protoplant/layer-adhesion-tester/(threads)

Thread 1 (2024-11-17):

Cannot compile code in IDE

makoman1860, 2024-11-17:
Keep getting the following error:
C:\Users\novak\AppData\Local\Temp\.arduinoIDE-unsaved20241017-6828-12k9i9d.rv2df\sketch_nov17a\sketch_nov17a.ino:3:4: error: stray '\' in program
 }c:\Users\novak\OneDrive\Documents\Arduino\layer-adhesion-tester-main\layer-adhesion-tester\layer-adhesion-tester.ino
    ^
C:\Users\novak\AppData\Local\Temp\.arduinoIDE-unsaved20241017-6828-12k9i9d.rv2df\sketch_nov17a\sketch_nov17a.ino:3:10: error: stray '\' in program
 }c:\Users\novak\OneDrive\Documents\Arduino\layer-adhesion-tester-main\layer-adhesion-tester\layer-adhesion-tester.ino
          ^
C:\Users\novak\AppData\Local\Temp\.arduinoIDE-unsaved20241017-6828-12k9i9d.rv2df\sketch_nov17a\sketch_nov17a.ino:3:16: error: stray '\' in program
 }c:\Users\novak\OneDrive\Documents\Arduino\layer-adhesion-tester-main\layer-adhesion-tester\layer-adhesion-tester.ino
                ^
C:\Users\novak\AppData\Local\Temp\.arduinoIDE-unsaved20241017-6828-12k9i9d.rv2df\sketch_nov17a\sketch_nov17a.ino:3:25: error: stray '\' in program
 }c:\Users\novak\OneDrive\Documents\Arduino\layer-adhesion-tester-main\layer-adhesion-tester\layer-adhesion-tester.ino
                         ^
C:\Users\novak\AppData\Local\Temp\.arduinoIDE-unsaved20241017-6828-12k9i9d.rv2df\sketch_nov17a\sketch_nov17a.ino:3:35: error: stray '\' in program
 }c:\Users\novak\OneDrive\Documents\Arduino\layer-adhesion-tester-main\layer-adhesion-tester\layer-adhesion-tester.ino
                                   ^
C:\Users\novak\AppData\Local\Temp\.arduinoIDE-unsaved20241017-6828-12k9i9d.rv2df\sketch_nov17a\sketch_nov17a.ino:3:43: error: stray '\' in program
 }c:\Users\novak\OneDrive\Documents\Arduino\layer-adhesion-tester-main\layer-adhesion-tester\layer-adhesion-tester.ino
                                           ^
C:\Users\novak\AppData\Local\Temp\.arduinoIDE-unsaved20241017-6828-12k9i9d.rv2df\sketch_nov17a\sketch_nov17a.ino:3:70: error: stray '\' in program
 }c:\Users\novak\OneDrive\Documents\Arduino\layer-adhesion-tester-main\layer-adhesion-tester\layer-adhesion-tester.ino
                                                                      ^
C:\Users\novak\AppData\Local\Temp\.arduinoIDE-unsaved20241017-6828-12k9i9d.rv2df\sketch_nov17a\sketch_nov17a.ino:3:92: error: stray '\' in program
 }c:\Users\novak\OneDrive\Documents\Arduino\layer-adhesion-tester-main\layer-adhesion-tester\layer-adhesion-tester.ino
                                                                                            ^
C:\Users\novak\AppData\Local\Temp\.arduinoIDE-unsaved20241017-6828-12k9i9d.rv2df\sketch_nov17a\sketch_nov17a.ino:3:1: error: expected declaration before '}' token
 }c:\Users\novak\OneDrive\Documents\Arduino\layer-adhesion-tester-main\layer-adhesion-tester\layer-adhesion-tester.ino
 ^

exit status 1

Compilation error: stray '\' in program

rekursiv, 2024-11-26:
Looks like your directory structure in your Arduino project is not set up properly.  If you clone the entire repo into your "Sketchbook" directory, within a subdirectory named "layer-adhesion-tester," then it should compile, as long as your IDE is set up correctly.  Note that you need the subdirectory and files within the "src" directory in the repo, as the project makes use of the "hx711-pico-c" library.

Closed 2025-09-17.

Thread 2 (2024-11-17):

ERPROM.h not found

makoman1860, 2024-11-17:
C:\Users\novak\OneDrive\Documents\GitHub\layer-adhesion-tester\layer-adhesion-tester.ino:37:10: fatal error: EEPROM.h: No such file or directory
 #include <EEPROM.h>
          ^~~~~~~~~~
compilation terminated.
exit status 1

Compilation error: EEPROM.h: No such file or directory

rekursiv, 2024-11-26:
Did you follow the [instructions here](https://arduino-pico.readthedocs.io/en/stable/install.html) for installing Arduino-Pico?
If so, could you please verify its installation in the "Boards Manager?"
(Example screen shot attached)
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
