protoplant/layer-adhesion-tester/serialplot.ini

[MainWindow]
size=@Size(1658 1351)
pos=@Point(55 28)
activePanel=Port
hidePanels=false
maximized=false
state=@ByteArray(\0\0\0\xff\0\0\0\0\xfd\0\0\0\0\0\0\x6z\0\0\x4\xd7\0\0\0\x4\0\0\0\x4\0\0\0\b\0\0\0\b\xfc\0\0\0\x1\0\0\0\x2\0\0\0\x3\0\0\0\f\0t\0\x62\0P\0l\0o\0t\x1\0\0\0\0\xff\xff\xff\xff\0\0\0\0\0\0\0\0\0\0\0\x1a\0t\0\x62\0P\0o\0r\0t\0\x43\0o\0n\0t\0r\0o\0l\x1\0\0\0q\xff\xff\xff\xff\0\0\0\0\0\0\0\0\0\0\0\x10\0t\0\x62\0R\0\x65\0\x63\0o\0r\0\x64\x1\0\0\x1\xba\xff\xff\xff\xff\0\0\0\0\0\0\0\0)

[Port]
selectedPort=
baudRate=9600
parity=none
dataBits=8
stopBits=1
flowControl=none

[DataFormat]
format=ascii

[DataFormat_Binary]
numOfChannels=2
numberFormat=uint8
endianness=little

[DataFormat_ASCII]
numOfChannels=2
delimiter=","
customDelimiter=}
filterMode=disabled
filterPrefix=" "

[DataFormat_CustomFrame]
numOfChannels=1
numberFormat=uint8
endianness=little
frameStart=AA BB
fixedSize=false
frameSize=1
checksum=false
debugMode=false

[Channels]
channel\1\name=Cur
channel\1\color=@Variant(\0\0\0\x43\x1\xff\xff\xff\xff\0\0VV\0\0)
channel\1\visible=true
channel\1\gain=1
channel\1\gainEnabled=false
channel\1\offset=0
channel\1\offsetEnabled=false
channel\2\name=Max
channel\2\color=@Variant(\0\0\0\x43\x1\xff\xff~~--\xd2\xd2\0\0)
channel\2\visible=true
channel\2\gain=1
channel\2\gainEnabled=false
channel\2\offset=0
channel\2\offsetEnabled=false
channel\size=2

[Plot]
numOfSamples=150
plotWidth=150
indexAsX=false
xMax=1000
xMin=0
autoScale=true
yMax=1
yMin=-1
darkBackground=true
grid=true
minorGrid=true
legend=true
multiPlot=false
symbols=auto
numLines=500
decimals=0

[Commands]
command\1\name=Command 1
command\1\type=ascii
command\1\data=t
command\2\name=Command 2
command\2\type=ascii
command\2\data=r
command\size=2

[Record]
autoIncrement=true
recordPaused=true
stopOnClose=true
header=true
disableBuffering=false
separator=","
decimals=6
timestamp=false
timestampFormat=seconds

[UpdateCheck]
periodicCheck=true
lastCheck=2024-02-20
