protoplant/layer-adhesion-tester/src/hx711-pico-c/util.h

// MIT License
// 
// Copyright (c) 2023 Daniel Robertson
// 
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
#ifndef UTIL_H_BC9FF78B_B978_444A_8AA1_FF169B09B09E
#define UTIL_H_BC9FF78B_B978_444A_8AA1_FF169B09B09E

#include <stdint.h>
#include "hardware/pio.h"
#include "hardware/platform_defs.h"
#include "hardware/sync.h"
#include "pico/mutex.h"
#include "pico/types.h"

#ifdef __cplusplus
extern "C" {
#endif

// RP2040 sdk doesn't seem to define this
#define UTIL_NUM_DMA_IRQS UINT8_C(2)

#define UTIL_DMA_IRQ_INDEX_MIN UINT8_C(0)
#define UTIL_DMA_IRQ_INDEX_MAX UINT8_C(UTIL_NUM_DMA_IRQS - 1)

#define UTIL_PIO_IRQ_INDEX_MIN UINT8_C(0)
#define UTIL_PIO_IRQ_INDEX_MAX UINT8_C(NUM_PIOS - 1)

#define UTIL_PIO_INTERRUPT_NUM_MIN UINT8_C(0)
#define UTIL_PIO_INTERRUPT_NUM_MAX UINT8_C(7)

#define UTIL_ROUTABLE_PIO_INTERRUPT_NUM_MIN UINT8_C(0)
#define UTIL_ROUTABLE_PIO_INTERRUPT_NUM_MAX UINT8_C(3)

/**
 * @brief Own a mutex for the duration of this block of
 * code.
 * @example UTIL_MUTEX_BLOCK(mut, 
 *  // do something...
 * );
 */
#define UTIL_MUTEX_BLOCK(mut, ...) \
    do { \
        mutex_enter_blocking(&mut); \
        __VA_ARGS__ \
        mutex_exit(&mut); \
    } while(0)

/**
 * @brief Disable interrupts for the duration of this block of
 * code.
 * @example UTIL_INTERRUPTS_OFF_BLOCK(
 *  // do something atomically...
 * );
 * @note the interrupt_status var is uniquely named to avoid
 * variable conflicts within the block.
 */
#define UTIL_INTERRUPTS_OFF_BLOCK(...) \
    do { \
        const uint32_t interrupt_status_cb918069_eadf_49bc_9d8c_a8a4defad20c = save_and_disable_interrupts(); \
        __VA_ARGS__ \
        restore_interrupts(interrupt_status_cb918069_eadf_49bc_9d8c_a8a4defad20c); \
    } while(0)

#define UTIL_DECL_IN_RANGE_FUNC(TYPE) \
    bool util_ ## TYPE ##_in_range( \
        const TYPE val, \
        const TYPE min, \
        const TYPE max);

UTIL_DECL_IN_RANGE_FUNC(int32_t)
UTIL_DECL_IN_RANGE_FUNC(uint32_t)
UTIL_DECL_IN_RANGE_FUNC(int)
UTIL_DECL_IN_RANGE_FUNC(uint)

/**
 * @brief Quick lookup for finding an NVIC IRQ number
 * for a PIO and interrupt index number.
 * @note Each PIO has two interrupts, hence why this
 * array is doubled.
 */
extern const uint8_t util_pio_to_irq_map[NUM_PIOS * 2];

/**
 * @brief Quick lookup for finding an NVIC IRQ number
 * for a DMA interrupt index number.
 */
extern const uint8_t util_dma_to_irq_map[UTIL_NUM_DMA_IRQS];

/**
 * @brief Check whether a DMA IRQ index is valid.
 * 
 * @param idx 
 * @return true 
 * @return false 
 */
bool util_dma_irq_index_is_valid(const uint idx);

/**
 * @brief Gets the NVIC DMA IRQ number using the DMA
 * IRQ index.
 * 
 * @param idx 
 * @return uint 
 */
uint util_dma_get_irq_from_index(const uint idx);

/**
 * @brief Gets the DMA IRQ index using the NVIC IRQ
 * number.
 * 
 * @param irq_num 
 * @return int -1 is returned for no match.
 */
int util_dma_get_index_from_irq(const uint irq_num);

/**
 * @brief Set and enable an exclusive handler for a
 * DMA channel.
 * 
 * @param irq_index 
 * @param channel 
 * @param handler 
 * @param enabled 
 */
void util_dma_set_exclusive_channel_irq_handler(
    const uint irq_index,
    const uint channel,
    const irq_handler_t handler,
    const bool enabled);

/**
 * @brief Get the transfer count for a given DMA channel. When a
 * DMA transfer is active, this count is the number of transfers
 * remaining.
 * 
 * @param channel 
 * @return uint32_t 
 */
uint32_t util_dma_get_transfer_count(const uint channel);

/**
 * @brief Wait until channel has completed transferring up
 * to a timeout.
 * 
 * @param channel 
 * @param end 
 * @return true if transfer completed
 * @return false is timeout was reached
 */
bool util_dma_channel_wait_for_finish_timeout(
    const uint channel,
    const absolute_time_t* const end);

/**
 * @brief Gets the NVIC IRQ number based on the DMA IRQ
 * index.
 * 
 * @param irq_index 0 or 1
 * @return uint DMA_IRQ_0 or DMA_IRQ_1
 */
uint util_dma_get_irqn(const uint irq_index);

/**
 * @brief Sets a DMA channel's IRQ quiet mode.
 * 
 * @param channel 
 * @param quiet true for quiet otherwise false
 */
void util_dma_channel_set_quiet(
    const uint channel,
    const bool quiet);

/**
 * @brief Sets GPIO pins from base to base + len to input.
 * 
 * @param base 
 * @param len 
 */
void util_gpio_set_contiguous_input_pins(
    const uint base,
    const uint len);

/**
 * @brief Initialises and sets GPIO pin to output.
 * 
 * @param gpio 
 */
void util_gpio_set_output(const uint gpio);

/**
 * @brief Set and enable an exclusive interrupt handler
 * for a given pio_interrupt_num.
 * 
 * @param pio 
 * @param irq_index 
 * @param pio_interrupt_num 
 * @param handler 
 * @param enabled 
 */
void util_irq_set_exclusive_pio_interrupt_num_handler(
    PIO const pio,
    const uint irq_index,
    const uint pio_interrupt_num,
    const irq_handler_t handler,
    const bool enabled);

/**
 * @brief Check whether PIO IRQ index is valid
 * 
 * @param idx 
 * @return true 
 * @return false 
 */
bool util_pio_irq_index_is_valid(const uint idx);

/**
 * @brief Gets the NVIC PIO IRQ number using a PIO
 * pointer and PIO IRQ index.
 * 
 * @param idx 
 * @return uint 
 */
uint util_pio_get_irq_from_index(
    PIO const pio,
    const uint idx);

/**
 * @brief Gets the PIO IRQ index using the NVIC IRQ
 * number.
 * 
 * @param irq_num 
 * @return int -1 is returned for no match.
 */
int util_pio_get_index_from_irq(const uint irq_num);

/**
 * @brief Gets the PIO using the NVIC IRQ number.
 * 
 * @param irq_num 
 * @return PIO const 
 */
PIO const util_pio_get_pio_from_irq(const uint irq_num);

/**
 * @brief Gets the correct NVIC IRQ number for a PIO
 * according to the IRQ index.
 * 
 * @example util_pion_get_irqn(pio1, 1); //returns PIO1_IRQ_1
 * 
 * @param pio 
 * @param irq_index 0 or 1
 * @return uint 
 */
uint util_pion_get_irqn(
    PIO const pio,
    const uint irq_index);

/**
 * @brief Gets the correct PIO interrupt source number according
 * to the raw PIO interrupt number used in a .pio file.
 * 
 * @example util_pio_get_pis_from_pio_interrupt_num(3); //returns pis_interrupt3 (11)
 * 
 * @see pio_interrupt_source
 * @param pio_interrupt_num 
 * @return uint 
 */
uint util_pio_get_pis_from_pio_interrupt_num(
    const uint pio_interrupt_num);

/**
 * @brief Inits GPIO pins for PIO from base to base + len.
 * 
 * @param pio 
 * @param base 
 * @param len 
 */
void util_pio_gpio_contiguous_init(
    PIO const pio,
    const uint base,
    const uint len);

/**
 * @brief Clears a given state machine's RX FIFO.
 * 
 * @param pio 
 * @param sm 
 */
void util_pio_sm_clear_rx_fifo(
    PIO const pio,
    const uint sm);

/**
 * @brief Clears a given state machine's OSR.
 * 
 * @param pio 
 * @param sm 
 */
void util_pio_sm_clear_osr(
    PIO const pio,
    const uint sm);

/**
 * @brief Clears a given state machine's ISR.
 * 
 * @param pio 
 * @param sm 
 */
void util_pio_sm_clear_isr(
    PIO const pio,
    const uint sm);

/**
 * @brief Check whether a given state machine is enabled.
 * 
 * @param pio 
 * @param sm 
 * @return true 
 * @return false 
 */
bool util_pio_sm_is_enabled(
    PIO const pio,
    const uint sm);

/**
 * @brief Check whether a PIO interrupt number is valid.
 * 
 * @param pio_interrupt_num 
 * @return true 
 * @return false 
 */
bool util_pio_interrupt_num_is_valid(
    const uint pio_interrupt_num);

/**
 * @brief Check whether a PIO interrupt number is
 * a valid routable interrupt number.
 * 
 * @param pio_interrupt_num 
 * @return true 
 * @return false 
 */
bool util_routable_pio_interrupt_num_is_valid(
    const uint pio_interrupt_num);

/**
 * @brief Waits for a given PIO interrupt to be set.
 * 
 * @param pio 
 * @param pio_interrupt_num 
 */
void util_pio_interrupt_wait(
    PIO const pio,
    const uint pio_interrupt_num);

/**
 * @brief Waits until a given PIO interrupt is cleared.
 * 
 * @param pio 
 * @param pio_interrupt_num 
 */
void util_pio_interrupt_wait_cleared(
    PIO const pio,
    const uint pio_interrupt_num);

/**
 * @brief Waits until the given interrupt is cleared, up to
 * a maximum timeout.
 * 
 * @param pio 
 * @param pio_interrupt_num 
 * @param end 
 * @return true 
 * @return false 
 */
bool util_pio_interrupt_wait_cleared_timeout(
    PIO const pio,
    const uint pio_interrupt_num,
    const absolute_time_t* const end);

/**
 * @brief Waits for a given PIO interrupt to be set and then
 * clears it.
 * 
 * @param pio 
 * @param pio_interrupt_num 
 */
void util_pio_interrupt_wait_clear(
    PIO const pio,
    const uint pio_interrupt_num);

/**
 * @brief Waits for a given PIO to be set within the timeout
 * period.
 * 
 * @param pio 
 * @param pio_interrupt_num 
 * @param end
 * @return true if the interrupt was set within the timeout
 * @return false if the timeout was reached
 */
bool util_pio_interrupt_wait_timeout(
    PIO const pio,
    const uint pio_interrupt_num,
    const absolute_time_t* const end);

/**
 * @brief Waits for a given PIO to be set within the timeout
 * period and then clears it.
 * 
 * @param pio 
 * @param pio_interrupt_num 
 * @param end
 * @return true if the interrupt was set within the timeout
 * @return false if the timeout was reached
 */
bool util_pio_interrupt_wait_clear_timeout(
    PIO const pio,
    const uint pio_interrupt_num,
    const absolute_time_t* const end);

/**
 * @brief Attempts to get a word from the state machine's RX FIFO
 * if more than threshold words are in the buffer.
 * 
 * @param pio 
 * @param sm 
 * @param word variable to be set
 * @param threshold word count (1 word = 8 bytes)
 * @return true if word was set with the value from the RX FIFO
 * @return false if the number of words in the RX FIFO is below
 * the threshold
 */
bool util_pio_sm_try_get(
    PIO const pio,
    const uint sm,
    uint32_t* const word,
    const uint threshold);

#undef UTIL_DECL_IN_RANGE_FUNC

#ifdef __cplusplus
}
#endif

#endif
